Joaobidese/monitoramento-freezers-iot/src/esp32/esp32_server/config.example.h

// Modelo de configuração local.
//
// Copie este arquivo para "config.h" (na mesma pasta) e preencha com os seus
// dados. O config.h está no .gitignore, então as credenciais reais nunca vão
// para o repositório.

#pragma once

// Credenciais da rede Wi-Fi
#define WIFI_SSID  "SUA_REDE"
#define WIFI_SENHA "SUA_SENHA"

// Telegram: token do bot (@BotFather) e ID do grupo que recebe os alertas.
// Deixe "SEU_CHAT_ID" para desativar o envio.
#define TELEGRAM_TOKEN   "SEU_TOKEN"
#define TELEGRAM_CHAT_ID "SEU_CHAT_ID"
