Joaobidese/monitoramento-freezers-iot/(commit log)

2026-09-17 feat: cria arquivo base do servidor ESP32
2026-09-17 feat: implementa codigo base funcional do servidor HTTP no ESP32
2026-11-04 Delete esp32_server.ino
    chore: remove arquivo enviado na pasta errada
2026-11-04 fix: remove delay bloqueante, centraliza leitura e trata falha dos sensores
    Loop passa a usar millis() em vez de delay(2000), sem bloquear o servidor. Sensores lidos em um único ponto. Leitura -127 exibida como FALHA.
2026-11-05 feat: exibe IP, MAC e status da conexao no painel
    Selo de status passa a refletir WiFi.status() em vez de texto fixo. Novo card com SSID, IP e MAC. Linha de status do Wi-Fi no OLED.
2026-11-09 feat: registra temperaturas minima e maxima
    Mínimo e máximo por sensor desde a inicialização, exibidos em cada card. Leituras com falha são ignoradas.
2026-11-09 feat: cria log persistente na flash com pagina /log
    Log em LittleFS com níveis INFO/AVISO/ERRO, gravado apenas em mudanças de estado e rotacionado acima de 16 KB. Rota /log exibe o histórico.
2026-11-09 feat: adiciona atuador controlado pela rota /atuador
    Buzzer no GPIO 23 acionado via /atuador?estado=on|off, com resposta 400 para comando inválido. Card com estado e botões no painel, status no OLED e registro no log.
2026-11-10 feat: adiciona data/hora via NTP e reconexao automatica do Wi-Fi
    Data e hora reais no log via NTP (horário de Brasília, UTC-3), com fallback para o tempo desde a inicialização quando não há internet. Detecção de queda do Wi-Fi com nova tentativa a cada 10 s, sem bloquear o loop, registrada no log (ERRO na queda e INFO na reconexão com o tempo fora).
2026-11-10 fix: restaura icone de floco de neve no cabecalho do painel
    O emoji havia sido perdido no commit anterior. Agora usa entidade HTML (&#10052;&#65039;), que não depende da codificação do arquivo-fonte.
2026-11-10 security: move credenciais do Wi-Fi para config.h fora do Git
    SSID e senha deixam de ficar fixos no código. Cada integrante cria seu config.h a partir de config.example.h; o config.h está no .gitignore. Sem ele, o projeto compila com o modelo e emite um aviso.
2026-11-10 feat: detecta falha persistente dos sensores
    Conta leituras seguidas sem resposta de cada DS18B20. Após 5 falhas (~10 s) registra ERRO no log uma única vez, separando ruído isolado de defeito real. O card do painel passa a mostrar há quantos segundos o sensor está sem leitura.
2026-11-10 feat: adiciona rota /status com estado do sistema em JSON
    Retorna temperaturas atuais, mínima/máxima, falhas seguidas e alerta de cada sensor, além de Wi-Fi (SSID, IP, RSSI), atuador, sincronização NTP e uptime. Valores sem leitura válida saem como null. Facilita testes com curl e integração com outros sistemas. Link adicionado no cabeçalho do painel.
2026-11-10 docs: reescreve README com ligacoes, API e instrucoes de instalacao
    Corrige a formatação Markdown quebrada e documenta funcionalidades, tabela de ligações dos pinos, rotas HTTP (incluindo /status com exemplo de JSON), testes com curl, bibliotecas necessárias, configuração do config.h e passo a passo para gravar no ESP32.
2026-11-10 test: adiciona evidencias de testes de rede, sensores, atuador e reconexao
2026-11-10 feat: alarme automatico com Telegram e painel web redesenhado
    - Remove a detecção de falha persistente e a rota /status em JSON (fora do escopo exigido).
    - Remove a configuração manual dos endereços dos sensores; os endereços são lidos ao ligar
    e, se um sensor não for encontrado, o card mostra FALHA e o log registra ERRO.
    - Limite de temperatura aplicado só ao sensor interno; o externo mede o ambiente e fica
    vermelho apenas em falha.
    - Limite de 7 °C para a demonstração com gelo (em freezer real seria -10 °C).
    - Buzzer liga automaticamente quando a temperatura interna passa do limite e desliga quando
    normaliza; o botão Desligar do painel silencia o alarme.
    - Envio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
